hadongzhu/music_strip/sources/mul_LUT_20.v

`timescale 1ns / 1ps

module mul_LUT_20(
    input   [7:0]       in,
    output  [7:0]       out
    );
    
    reg     [7:0]       _out;
    
    assign out = _out;
    
    always @(*) begin
        casex(in)

            8'b00000000 : _out = 0;
            8'b00000001 : _out = 0;
            8'b00000010 : _out = 0;
            8'b00000011 : _out = 0;
            8'b00000100 : _out = 0;
            8'b00000101 : _out = 1;
            8'b00000110 : _out = 1;
            8'b00000111 : _out = 1;
            8'b00001000 : _out = 1;
            8'b00001001 : _out = 1;
            8'b00001010 : _out = 2;
            8'b00001011 : _out = 2;
            8'b00001100 : _out = 2;
            8'b00001101 : _out = 2;
            8'b00001110 : _out = 2;
            8'b00001111 : _out = 3;
            8'b00010000 : _out = 3;
            8'b00010001 : _out = 3;
            8'b00010010 : _out = 3;
            8'b00010011 : _out = 3;
            8'b00010100 : _out = 4;
            8'b00010101 : _out = 4;
            8'b00010110 : _out = 4;
            8'b00010111 : _out = 4;
            8'b00011000 : _out = 4;
            8'b00011001 : _out = 5;
            8'b00011010 : _out = 5;
            8'b00011011 : _out = 5;
            8'b00011100 : _out = 5;
            8'b00011101 : _out = 5;
            8'b00011110 : _out = 6;
            8'b00011111 : _out = 6;
            8'b00100000 : _out = 6;
            8'b00100001 : _out = 6;
            8'b00100010 : _out = 6;
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
            8'b11100110 : _out = 46;
            8'b11100111 : _out = 46;
            8'b11101000 : _out = 46;
            8'b11101001 : _out = 46;
            8'b11101010 : _out = 46;
            8'b11101011 : _out = 47;
            8'b11101100 : _out = 47;
            8'b11101101 : _out = 47;
            8'b11101110 : _out = 47;
            8'b11101111 : _out = 47;
            8'b11110000 : _out = 48;
            8'b11110001 : _out = 48;
            8'b11110010 : _out = 48;
            8'b11110011 : _out = 48;
            8'b11110100 : _out = 48;
            8'b11110101 : _out = 49;
            8'b11110110 : _out = 49;
            8'b11110111 : _out = 49;
            8'b11111000 : _out = 49;
            8'b11111001 : _out = 49;
            8'b11111010 : _out = 50;
            8'b11111011 : _out = 50;
            8'b11111100 : _out = 50;
            8'b11111101 : _out = 50;
            8'b11111110 : _out = 50;
            8'b11111111 : _out = 51;


            default: _out = 51;
        
        endcase
        
    end
endmodule
