hadongzhu/music_strip/sources/mul_LUT_90.v

`timescale 1ns / 1ps

module mul_LUT_90(
    input   [7:0]       in,
    output  [7:0]       out
    );
    
    reg     [7:0]       _out;
    
    assign out = _out;
    
    always @(*) begin
        casex(in)

            8'b00000000 : _out = 0;
            8'b00000001 : _out = 0;
            8'b00000010 : _out = 1;
            8'b00000011 : _out = 2;
            8'b00000100 : _out = 3;
            8'b00000101 : _out = 4;
            8'b00000110 : _out = 5;
            8'b00000111 : _out = 6;
            8'b00001000 : _out = 7;
            8'b00001001 : _out = 8;
            8'b00001010 : _out = 9;
            8'b00001011 : _out = 9;
            8'b00001100 : _out = 10;
            8'b00001101 : _out = 11;
            8'b00001110 : _out = 12;
            8'b00001111 : _out = 13;
            8'b00010000 : _out = 14;
            8'b00010001 : _out = 15;
            8'b00010010 : _out = 16;
            8'b00010011 : _out = 17;
            8'b00010100 : _out = 18;
            8'b00010101 : _out = 18;
            8'b00010110 : _out = 19;
            8'b00010111 : _out = 20;
            8'b00011000 : _out = 21;
            8'b00011001 : _out = 22;
            8'b00011010 : _out = 23;
            8'b00011011 : _out = 24;
            8'b00011100 : _out = 25;
            8'b00011101 : _out = 26;
            8'b00011110 : _out = 27;
            8'b00011111 : _out = 27;
            8'b00100000 : _out = 28;
            8'b00100001 : _out = 29;
            8'b00100010 : _out = 30;
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
            8'b11100001 : _out = 202;
            8'b11100010 : _out = 203;
            8'b11100011 : _out = 204;
            8'b11100100 : _out = 205;
            8'b11100101 : _out = 206;
            8'b11100110 : _out = 207;
            8'b11100111 : _out = 207;
            8'b11101000 : _out = 208;
            8'b11101001 : _out = 209;
            8'b11101010 : _out = 210;
            8'b11101011 : _out = 211;
            8'b11101100 : _out = 212;
            8'b11101101 : _out = 213;
            8'b11101110 : _out = 214;
            8'b11101111 : _out = 215;
            8'b11110000 : _out = 216;
            8'b11110001 : _out = 216;
            8'b11110010 : _out = 217;
            8'b11110011 : _out = 218;
            8'b11110100 : _out = 219;
            8'b11110101 : _out = 220;
            8'b11110110 : _out = 221;
            8'b11110111 : _out = 222;
            8'b11111000 : _out = 223;
            8'b11111001 : _out = 224;
            8'b11111010 : _out = 225;
            8'b11111011 : _out = 225;
            8'b11111100 : _out = 226;
            8'b11111101 : _out = 227;
            8'b11111110 : _out = 228;
            8'b11111111 : _out = 229;


            default: _out = 229;
        
        endcase
        
    end
endmodule
