hadongzhu/music_strip/sources/hamming.sv

`timescale 1ns / 1ps

module hamming(
    input           clk,
    input           reset,
    input   [15:0]  in,
    output  [15:0]  out,
    input           on
    );

    logic   [15:0]  shift_reg[512] = {16'd1311, 16'd1311, 16'd1313, 16'd1316, 16'd1320, 16'd1325, 16'd1331, 16'd1339, 16'd1347, 16'd1357, 16'd1368, 16'd1380, 16'd1393, 16'd1407, 16'd1422, 16'd1439, 16'd1456, 16'd1475, 16'd1495, 16'd1515, 16'd1537, 16'd1561, 16'd1585, 16'd1610, 16'd1637, 16'd1664, 16'd1693, 16'd1722, 16'd1753, 16'd1785, 16'd1818, 16'd1852, 16'd1887, 16'd1923, 16'd1960, 16'd1998, 16'd2037, 16'd2077, 16'd2119, 16'd2161, 16'd2204, 16'd2248, 16'd2294, 16'd2340, 16'd2387, 16'd2435, 16'd2484, 16'd2535, 16'd2586, 16'd2638, 16'd2691, 16'd2745, 16'd2799, 16'd2855, 16'd2912, 16'd2969, 16'd3028, 16'd3087, 16'd3147, 16'd3208, 16'd3270, 16'd3333, 16'd3397, 16'd3461, 16'd3526, 16'd3592, 16'd3659, 16'd3727, 16'd3795, 16'd3864, 16'd3934, 16'd4005, 16'd4076, 16'd4148, 16'd4221, 16'd4295, 16'd4369, 16'd4444, 16'd4519, 16'd4595, 16'd4672, 16'd4750, 16'd4828, 16'd4907, 16'd4986, 16'd5066, 16'd5146, 16'd5227, 16'd5309, 16'd5391, 16'd5473, 16'd5556, 16'd5640, 16'd5724, 16'd5809, 16'd5894, 16'd5979, 16'd6065, 16'd6152, 16'd6238, 16'd6325, 16'd6413, 16'd6501, 16'd6589, 16'd6678, 16'd6767, 16'd6856, 16'd6945, 16'd7035, 16'd7125, 16'd7216, 16'd7306, 16'd7397, 16'd7488, 16'd7579, 16'd7671, 16'd7762, 16'd7854, 16'd7946, 16'd8038, 16'd8130, 16'd8223, 16'd8315, 16'd8407, 16'd8500, 16'd8593, 16'd8685, 16'd8778, 16'd8871, 16'd8963, 16'd9056, 16'd9148, 16'd9241, 16'd9334, 16'd9426, 16'd9518, 16'd9611, 16'd9703, 16'd9795, 16'd9887, 16'd9978, 16'd10070, 16'd10161, 16'd10252, 16'd10343, 16'd1043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
    
    assign result = $signed(shift_reg[0])*$signed(in);
    assign out = result>>14;
    
    
    always_ff @(posedge clk) begin
            if(on) begin
                shift_reg[0] <= shift_reg[255];
                shift_reg[1:255] <= shift_reg[0:254];
            end
    end
endmodule
